Roulerrr/Robot-SPIDER/PART/1ea-Body Top Plate.FCStd

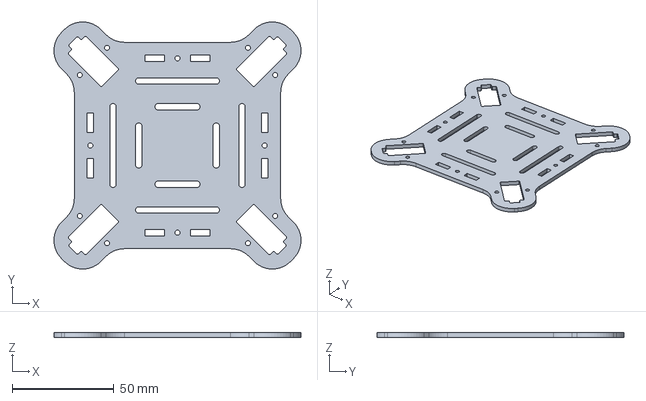
[picture p2: CAD file, 2025-02-12]
PART/1ea-Body Top Plate.FCStd
121.6 x 121.6 x 2.50 mm
