Roulerrr/Robot-SPIDER/PART/8ea-Servo Ratainer.FCStd

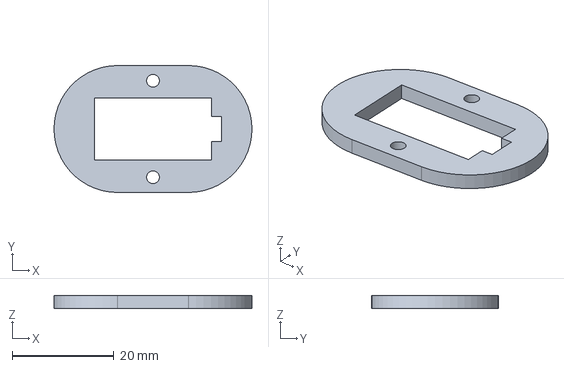
[picture p3: CAD file, 2025-02-12]
PART/8ea-Servo Ratainer.FCStd
39.0 x 25.0 x 2.50 mm
