Roulerrr/Robot-SPIDER/PART/4ea-Leg Servo Arm.FCStd

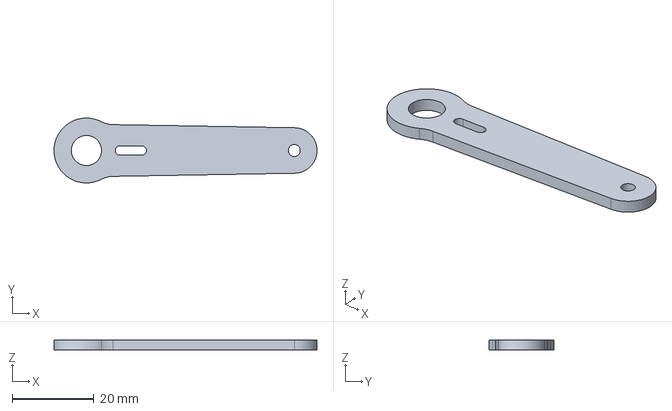
[picture p4: CAD file, 2025-02-12]
PART/4ea-Leg Servo Arm.FCStd
64.3 x 15.9 x 2.50 mm
