Roulerrr/Robot-SPIDER/PART/4ea-Leg Servo Mount.FCStd

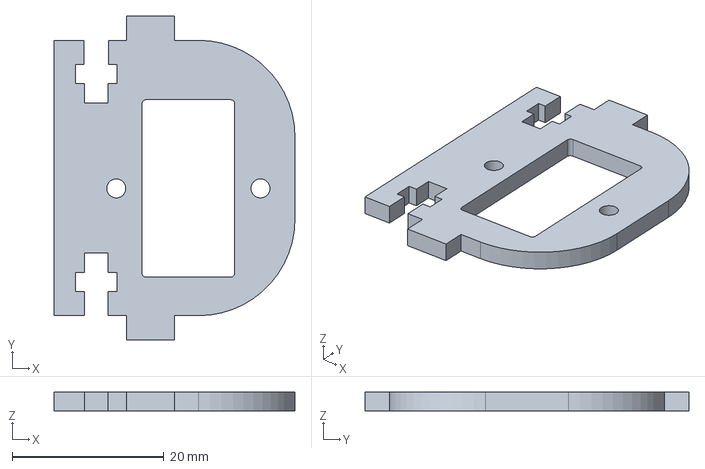
[picture p5: CAD file, 2025-02-12]
PART/4ea-Leg Servo Mount.FCStd
31.7 x 42.6 x 2.50 mm
