Roulerrr/Robot-SPIDER/PART/Body Spacer.FCStd

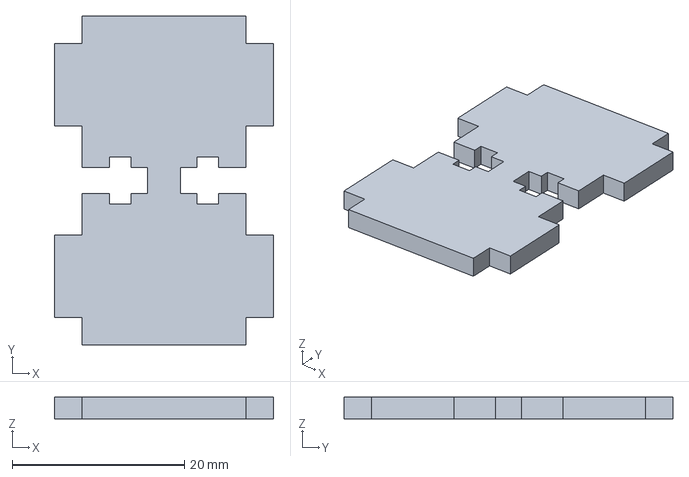
[picture p6: CAD file, 2025-02-12]
PART/Body Spacer.FCStd
25.4 x 38.1 x 2.50 mm
