Roulerrr/Robot-SPIDER/PART/4ea-Leg Parallel Plate.FCStd

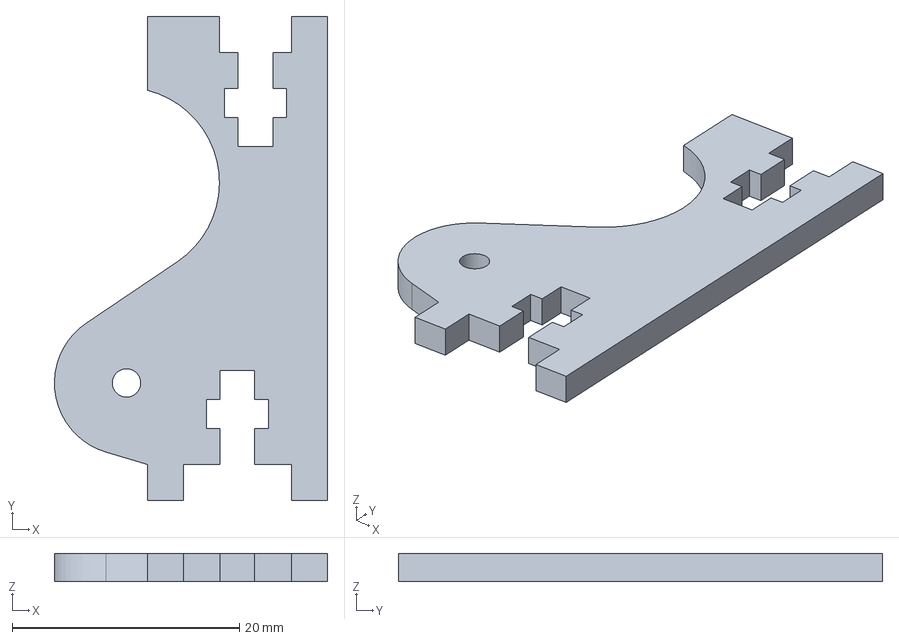
[picture p7: CAD file, 2025-02-12]
PART/4ea-Leg Parallel Plate.FCStd
24.1 x 42.6 x 2.50 mm
