Roulerrr/Robot-SPIDER/PART/4ea-Leg.FCStd

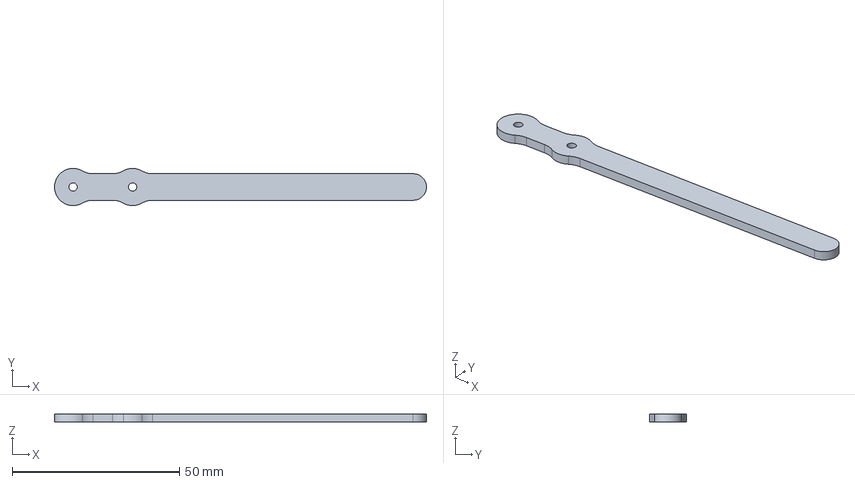
[picture p8: CAD file, 2025-02-12]
PART/4ea-Leg.FCStd
111.1 x 11.1 x 2.50 mm
