Roulerrr/Robot-SPIDER/PART/4ea-Leg Top Pivot Plate.FCStd

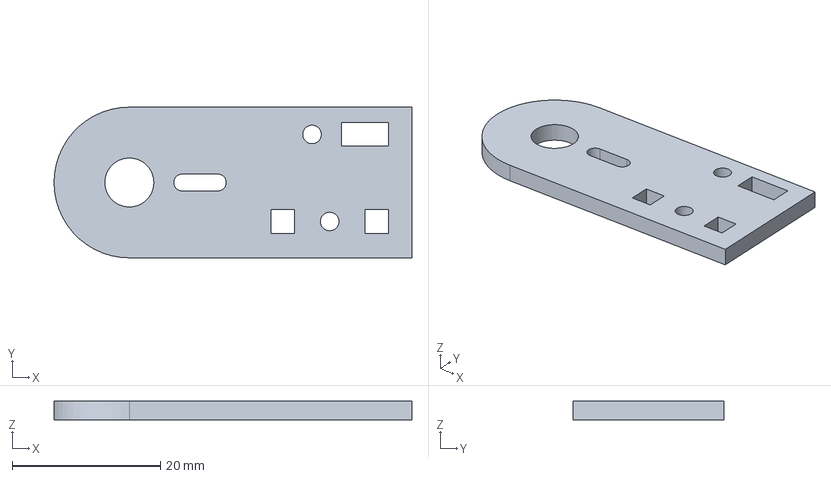
[picture p9: CAD file, 2025-02-12]
PART/4ea-Leg Top Pivot Plate.FCStd
48.3 x 20.3 x 2.50 mm
