Roulerrr/Robot-SPIDER/PART/4ea-Leg Parallel Joint.FCStd

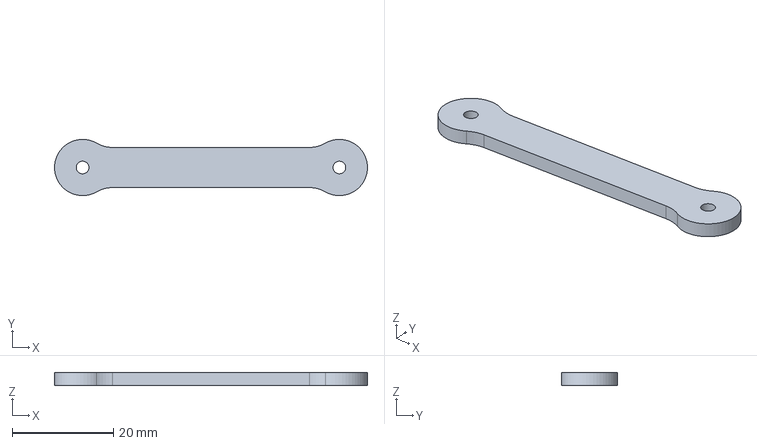
[picture p10: CAD file, 2025-02-12]
PART/4ea-Leg Parallel Joint.FCStd
61.9 x 11.1 x 2.50 mm
