Roulerrr/Robot-SPIDER/PART/Quadruped_Parts_v0.1a.dxf

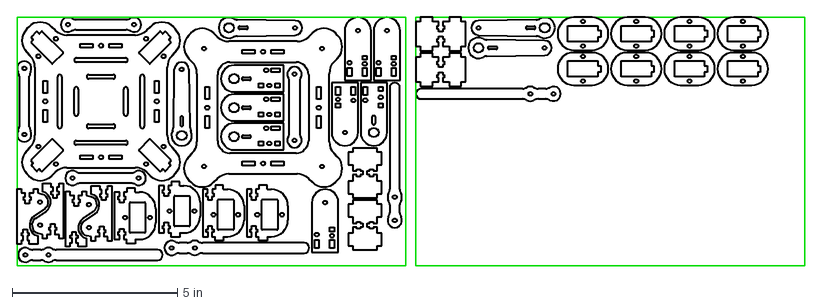
[picture p11: CAD file, 2025-02-12]
PART/Quadruped_Parts_v0.1a.dxf
23.8 x 7.53 in
