Roulerrr/Robot-SPIDER/PART/Quadruped_Parts_Spider.FCStd

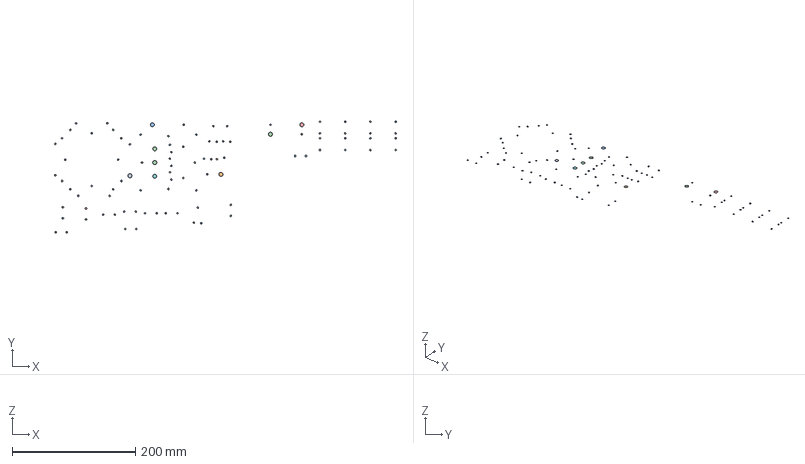
[picture p12: CAD file, 2025-02-12]
PART/Quadruped_Parts_Spider.FCStd
554.4 x 181.9 x 0 mm
Circle096
Circle097
Circle098
Circle099
Circle100
Circle101
Circle102
Circle
Circle103
Circle104
Circle105
Circle106
Circle107
Circle108
Circle109
Circle110
Circle111
Circle112
Circle113
Circle114
Circle115
Circle116
Circle117
Circle118
Circle119
Circle120
Circle121
Circle122
Circle123
Circle124
Circle125
Circle126
Circle127
Circle128
Circle129
Circle130
Circle131
Circle132
Circle133
Circle134
Circle135
Circle136
Circle137
Circle138
Circle139
Circle140
Circle141
Circle142
Circle143
Circle144
Circle145
Circle146
Circle147
Circle148
Circle149
Circle150
Circle151
Circle152
Circle153
Circle154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
