Roulerrr/Robot-SPIDER/(list of files, cad)

Other CAD files:
4ea-Leg Ver1.FCStd
PART/4ea-Leg Botton Pivot Plate.FCStd
